martinroger/MiniR56_RoundGauge_ESP32/README.md

An ESP32-based OBD Gauge for the R56 Mini Cooper

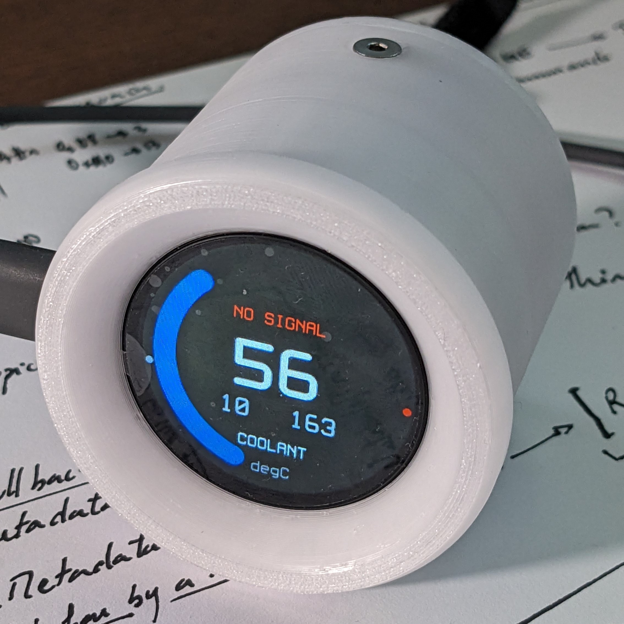
[picture p1: img/proto0.jpg]
Proto v0
