martinroger/MiniR56_RoundGauge_ESP32/PCB/Can and power/Can and Power PCBWay BOM.xlsx

 |  |  | xxxx xxxx xxxxx xxPCS BOM (Sample Bill of Materials)
Item # | *Designator | *Qty | Manufacturer | *Mfg Part # | Description / Value | *Package/Footprint | Type | Your Instructions / Notes
1 | C3, C4, C10 | 3 | YAGEO | CC0603KRX7R7BB104 | CAP CER 0.1UF 16V X7R 0603 | Capacitor_SMD:C_0603_1608Metric | SMD
2 | C6 | 1 | KEMET | C0603C822J3GAC7867 | CAP CER 8200PF 25V NP0 0603 | Capacitor_SMD:C_0603_1608Metric | SMD
3 | C7 | 1 | KEMET | C0603C472K4RAC7867 | CAP CER 4700PF 16V X7R 0603 | Capacitor_SMD:C_0603_1608Metric | SMD
4 | C8 | 1 | KYOCERA AVX | KGM15AR71C101KT | CAP CER 100PF 16V X7R 0603 | Capacitor_SMD:C_0603_1608Metric | SMD
5 | C9 | 1 | SAMSUNG | CL31B106KAHNNNE | CAP CER 10UF 25V X7R 1206 | Capacitor_SMD:C_1206_3216Metric | SMD
6 | C11 | 1 | SAMSUNG | CL10A106KP8NNNC | CAP CER 10UF 10V X5R 0603 | Capacitor_SMD:C_0603_1608Metric | SMD
7 | D1, D2 | 2 | LITTELFUSE | PESD0402-140 | LITTELFUSE - PESD0402-140 - ESD SUPPRESSOR, 0402, 14V, 0.25PF | SamacSys_Parts:DIONC1005X43N | SMD
8 | D3 | 1 | onsemi | SS24FL | ON SEMICONDUCTOR - SS24FL - SCHOTTKY RECT, AEC-Q101, 40V, SOD-123F | SamacSys_Parts:SODFL3617X108N | SMD
9 | D4 | 1 | Harvatek Corporation | B1911UD--20D001014U1930 | LED ORANGE DIFFUSED 0603 SMD | LED_SMD:LED_0603_1608Metric | SMD
10 | D5 | 1 | Harvatek Corporation | B1911UD--20D001014U1930 | LED ORANGE DIFFUSED 0603 SMD | LED_SMD:LED_0603_1608Metric | SMD
11 | J1 | 1 | Texas Instruments | TPS54232DR | TEXAS INSTRUMENTS - TPS54232DR - DC-DC Switching Buck Step Down Regulator, Adjustable, 3.5V-28Vin, 1 MHz, 0.8V-25V/2Aout, SOIC-8 | SamacSys_Parts:SOIC127P600X175-8N | SMD
12 | L2 | 1 | Bourns | SRN6045TA-150M | BOURNS - SRN6045TA-150M - INDUCTOR, AEC-Q200, 15UH, 2.8A, 20% | SamacSys_Parts:INDC6060X450N | SMD
13 | R1, R3 | 2 | YAGEO | RC0603FR-071KL | RES 1K OHM 1% 1/10W 0603 | Resistor_SMD:R_0603_1608Metric | SMD
14 | R2, R9 | 2 | YAGEO | RC0603FR-0710K2L | RES 10.2K OHM 1% 1/10W 0603 | Resistor_SMD:R_0603_1608Metric | SMD
15 | R4 | 1 | YAGEO | RC0603FR-0712K7L | RES 12.7K OHM 1% 1/10W 0603 | Resistor_SMD:R_0603_1608Metric | SMD
16 | R8 | 1 | Panasonic Electronic Components | ERJ-3EKF4702V | RES SMD 47K OHM 1% 1/10W 0603 | Resistor_SMD:R_0603_1608Metric | SMD
17 | R10 | 1 | YAGEO | RC0603FR-071K91L | RES 1.91K OHM 1% 1/10W 0603 | Resistor_SMD:R_0603_1608Metric | SMD
18 | Ren1 | 1 | YAGEO | RC0603FR-0766K5L | RES 66.5K OHM 1% 1/10W 0603 | Resistor_SMD:R_0603_1608Metric | SMD
19 | Ren2 | 1 | YAGEO | RC0603FR-077K5L | RES 7.5K OHM 1% 1/10W 0603 | Resistor_SMD:R_0603_1608Metric | SMD
20 | U1 | 1 | Texas Instruments | SN65HVD230DR | IC TRANSCEIVER HALF 1/1 8SOIC | Package_SO:SOIC-8_3.9x4.9mm_P1.27mm | SMD
