martinroger/MiniR56_RoundGauge_ESP32/PCB/Can and power/Can and power.step

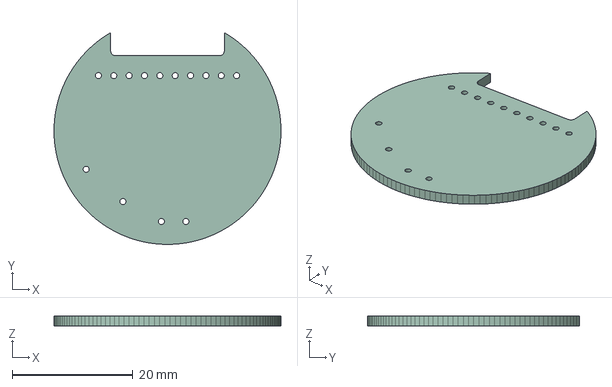
[picture p2: CAD file, 2024-06-08]
PCB/Can and power/Can and power.step
37.5 x 35.0 x 1.58 mm
