martinroger/MiniR56_RoundGauge_ESP32/PCB/Can and power/Can and power.kicad_pcb

## KiCad design PCB/Can and power/Can and power.kicad_pcb (2024-08-07)

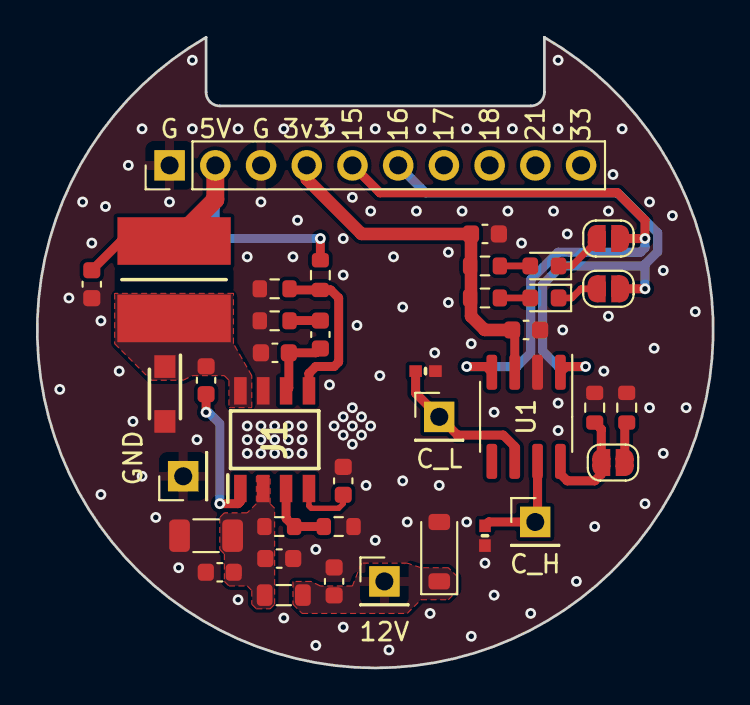
[picture p3: board Can and power.kicad_pcb from above]

Board: 2 copper layers, 37.5 x 35.0 mm, 38 parts (0 on the bottom side), 22 nets.

Parts:
C1, C2: 0.1uF 50V; C_0603_1608Metric
C3, C4, C10: 0.1uF; C_0603_1608Metric
C5: 1uF; C_0603_1608Metric
C6: 8200pF; C_0603_1608Metric
C7: 4700pF; C_0603_1608Metric
C8: 100pF; C_0603_1608Metric
C9: 10uF; C_1206_3216Metric
C11: 10uF; C_0603_1608Metric
D1, D2: PESD0402-140; DIONC1005X43N
D3: SS24FL; SODFL3617X108N
D4: 2V-20mA; LED_0603_1608Metric
D5: 2V - 20mA; LED_0603_1608Metric
D6: 18V; D_SOD-123
FB1: 120R@100MHz; L_0805_2012Metric
J1: TPS54232DR; SOIC127P600X175-8N
J2: ESP32; PinHeader_1x10_P2.54mm_Vertical
J3: 12V; PinHeader_1x01_P2.54mm_Vertical
J4: C_H; PinHeader_1x01_P2.54mm_Vertical
J5: C_L; PinHeader_1x01_P2.54mm_Vertical
J6: GND; PinHeader_1x01_P2.54mm_Vertical
JP1, JP2, JP3: SolderJumper_2_Open; SolderJumper-2_P1.3mm_Open_RoundedPad1.0x1.5mm
L2: SRN6045TA-150M; INDC6060X450N
R1, R3: 1k; R_0603_1608Metric
R2, R9: 10k2; R_0603_1608Metric
R4: 12k7; R_0603_1608Metric
R8: 47k; R_0603_1608Metric
R10: 1k91; R_0603_1608Metric
Ren1: 66k5; R_0603_1608Metric
Ren2: 7k5; R_0603_1608Metric
U1: SN65HVD230; SOIC-8_3.9x4.9mm_P1.27mm

Connections:
+3V3: C3.2, C4.1, J2.4, R1.2, R3.1, U1.3 (VCC)
+12V: C1.2, D6.1 (K), FB1.1, J3.1
GND: C1.1, C2.1, C3.1, C4.2, C5.2, C6.2, C8.2, C9.2, C11.2, D1.2, D2.2, D3.2, D6.2 (A), J1.7 (GND), J2.1, J2.3, J6.1, R2.1, R4.1, R8.2, R10.1, Ren2.1, U1.2 (GND)
GPIO15: J2.5, JP2.1 (A), U1.4 (R)
GPIO16: J2.6, JP3.1 (A), U1.1 (D)
unnamed: C7.2, R4.2
unnamed: D4.2 (A), R1.1
unnamed: D4.1 (K), JP2.2 (B)
unnamed: D5.2 (A), R3.2
unnamed: D5.1 (K), JP3.2 (B)
unnamed: C10.2, J1.1 (BOOT)
unnamed: C7.1, C8.1, J1.6 (COMP)
unnamed: J1.3 (EN), Ren1.1, Ren2.2
unnamed: C10.1, D3.1, J1.8 (PH), L2.1
unnamed: C6.1, J1.4 (SS)
unnamed: C2.2, C5.1, C9.1, FB1.2, J1.2 (VIN), Ren1.2
unnamed: J1.5 (VSENSE), R9.1, R10.2
unnamed: D1.1, J4.1, U1.7 (CANH)
unnamed: D2.1, J5.1, U1.6 (CANL)
unnamed: JP1.1 (A), R2.2
unnamed: JP1.2 (B), R8.1, U1.8 (Rs)
VSYS: C11.1, J2.2, L2.2, R9.2
