martinroger/MiniR56_RoundGauge_ESP32/(threads)

Thread 2 (2024-08-08):

OBD requests will persist even when key off as long as hysteresis voltage is met

martinroger, 2024-08-08:
Even after key off, ECUs will stay on and respond to UDS or OBD requests as long as the controller stays physically on (i.e. the Vin is not below the UVLO of the converter).
This can lead to a drained battery situation.
Solution : Check Frame 130h for ignition status and interrupt OBD/UDS/BMWFast requests when ignition is key out or engine off.

martinroger, 2024-08-24:
Working in 3e0e526, closing

Closed 2024-08-24.

Thread 3 (2024-08-24):

Brightness is not adjustable

martinroger, 2024-08-24:
Brightness either needs to be adjustable, or needs to find a way to check ambient light or the PWM setting on the vehicle

martinroger, 2024-08-26:
Implement gesture detection, either via lvgl or via the touch sensor?

Thread 4 (2024-08-24):

Boost pressure mins and maxs are wrong

martinroger, 2024-08-24:
Boost can be slightly negative. Normal range should be -255 to 255 kPa.

Closed 2024-08-24.

Thread 12 (2024-11-04):

Add IGNITION sensing to all HW

martinroger, 2024-11-04:
Affects primarily 1.28in but needs to be propagated to all branches . Individual issues to be created for workload

martinroger, 2025-09-22:
Update : add to the universal PCB, use optoisolator and route to available GPIO (preferably one that can sleep)

Thread 15 (2025-08-22):

Docs, instructions

AlexDaniel, 2025-08-22:
Hey!

Just stumbled upon this. What do you think, is the project ready to be built by others? Maybe you can provide some rough high-level instructions?

martinroger, 2025-08-22:
Hey @AlexDaniel
Realistically, not easily. It's kinda turned into a big sandbox/benchmark repo for a bunch of waveshare round displays, as I never really found one that fit the purpose perfectly and then got side tracked into two other projects (a BT iPod emulator and these days a more complete instrument cluster for another type of car).

Depending on your level with coding, this is still quite buildable, but the PCB for the CAN and Power feed from the OBD port could probably do with some minor adjustments so it doesn't suck the life out of your battery.

Currently the repo is roughly split in one branch per display type, plus some extras :

- 2.8C-AiO is for the newer Waveshare 2.8in circular display, which are a bit big for a side-mounted gauge, and I didn't design any enclosure for those. I haven't checked the code in a while but it should be relatively complete
- WS28_ESP32Panel_DriverBoard is for the more complicated to use Waveshare driver board, I do not recommend now that the 2.8C AiO is out
- WS185_ESP32Panel is in a need for a refresh, it uses the 1.85in waveshare circular display
- WE21_ESP32Panel is pretty much stale
- KWP was an attempt at not using standard OBD request PIDs and rather emulate a BMW diagnostic tool (remember that this is for a Mini R56, so BMW underneath). It's obviously less universal but gives access to new stuff that normal OBD PIDs don't have. Only works on BMW units though and it's quite complicated, I didn't make it very modular. I think it does have the latest KiCAD files for the adapter board that does the 12V -> 5V conversion and hosts a CAN transceiver. It does need a bit of documentation, and fiddling with the input power method, to use an ignition-switched pin instead of the normal battery power. Otherwise it will never shut down.

I'm not planning in the short term to work on this because I find it difficult to span over multiple projects simultaneously, eventually I will get back to it and settle on a single screen, single PCB and probably two versions of the code, one for OBD requests and one more elaborate that does KWP requests. But it's probably gonna be some months.

How do you feel about all that ?
