martinroger/MiniR56_RoundGauge_ESP32/(commit log)

2024-02-17 Added more dependencies for accelerometer and touch
2024-03-04 Small corrections on font and display
    [main.cpp]
2024-03-04 Added filters Library reference
2024-03-04 Timer implementation
2024-03-25 PCB for shield
    [Can and power.kicad_pcb, Can and power.kicad_sch, Can and power.sch]
2024-03-27 First PCBWay quotation
    [Can and power.kicad_pcb]
2024-03-28 First purchase
    [Can and power.kicad_pcb, Can and power.kicad_sch, Can and power.step]
2024-04-25 Change of transceiver
    For some reasons the TJA 1044 and 1049 get stuck in Standby mode all the time. Not sure why.
    [Can and power.kicad_pcb, Can and power.kicad_sch]
2024-04-25 LED resistor corrections
    [Can and power.kicad_pcb, Can and power.kicad_sch]
2024-04-26 Lazy TWAI implementation
    Implemented TWAI of the ESP32S3 on pins 15 and 16. Still reversible to MCP2515 implementation but eventually that will get squashed out.
2024-04-26 Clean-up code and sch, PCB layout is a WIP
    Code limited to TWAI implementation
    Schematic updated with solder bridges
    PCB layout is a WIP
    [Can and power.kicad_pcb, Can and power.kicad_sch]
2024-04-26 Resistor correction
    [Can and power.kicad_pcb, Can and power.kicad_sch]
2024-04-27 New shield design
    New shield design. MCP2515 is gone and transceiver has moved to SN65HVD230
    Enable pin on the converter is used to cut off the uC when below 12V. Resistor values may have to change.
    No real protection on start up stage -> might need another layer for that
    Updated INO to reflect the changes in pinout
    [Can and power.kicad_pcb, Can and power.kicad_sch, EN divided calc.xlsx]
2024-05-21 Update main.cpp
    Cut out the CAN bit to focus on LVGL manipulation
2024-06-07 CAD reference update
    [Can and Power PCBWay BOM.xlsx, Can and power.kicad_sch]
2024-06-07 10% Animation lag for less frame splitting
2024-06-08 Added protection diode on voltage input
    [Can and power.kicad_pcb, Can and power.kicad_sch]
2024-08-07 V4 PCB
    Ren1 and Ren2 values might not be discriminating enough
    [Can and power.kicad_pcb, Can and power.kicad_sch]
2024-08-08 Pending corrections on Ren1 and Ren2
    There is a discrepancy in the datasheet and the actual measured voltage hysteresis values. Increasing Ren1 and Ren2 to increase the trigger hysteresis.
    [Can and power.kicad_sch, EN divided calc.xlsx]
2024-08-15 Ignition state and key state handling
    Wordy alerts on screen in case of loss of KL15 or key. No countdown to deep sleep or anything like that yet.
2024-08-24 Bugfixing
    - Re-export STEP of board with components in 3D
    - Boost gauge limits fixed #4
    - No OBD query if CAN down or key missing #2
    - Wait for successful first read to update screen #5
    - Mishmash delay added (to be removed)
    - Brightness increased to 200 from 128
    [main.cpp]
2024-08-24 Hiding noise on startup, screen config is isolated
    - #6 is now fixed, solution is to start the screen dark and turn it on later in loop() via normal brightness control
    - Some hint about #7 that it may be a fade-in animation.
    - platformio.ini cleaned up
    [main.cpp, scrConfig.h]
2024-08-24 Splash screen fixed
    Fixed #7 using differential load animation.
    [main.cpp]
2024-08-24 Fix flickering issue
    Calling AnalogWrite every loop is unreasonable
    [main.cpp]
